Ak-yerr/MPPT-Solar-Charge-Controller-Project/Photos-&-Videos/Proto_1_Test_Circuit.jpg

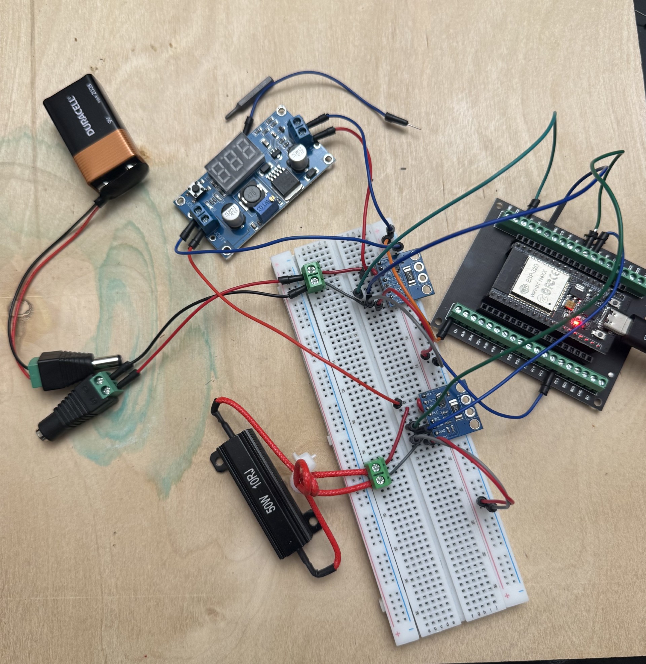
Photos-&-Videos/Proto_1_Test_Circuit.jpg
