Ak-yerr/MPPT-Solar-Charge-Controller-Project/Photos-&-Videos/async_buck_build.jpg

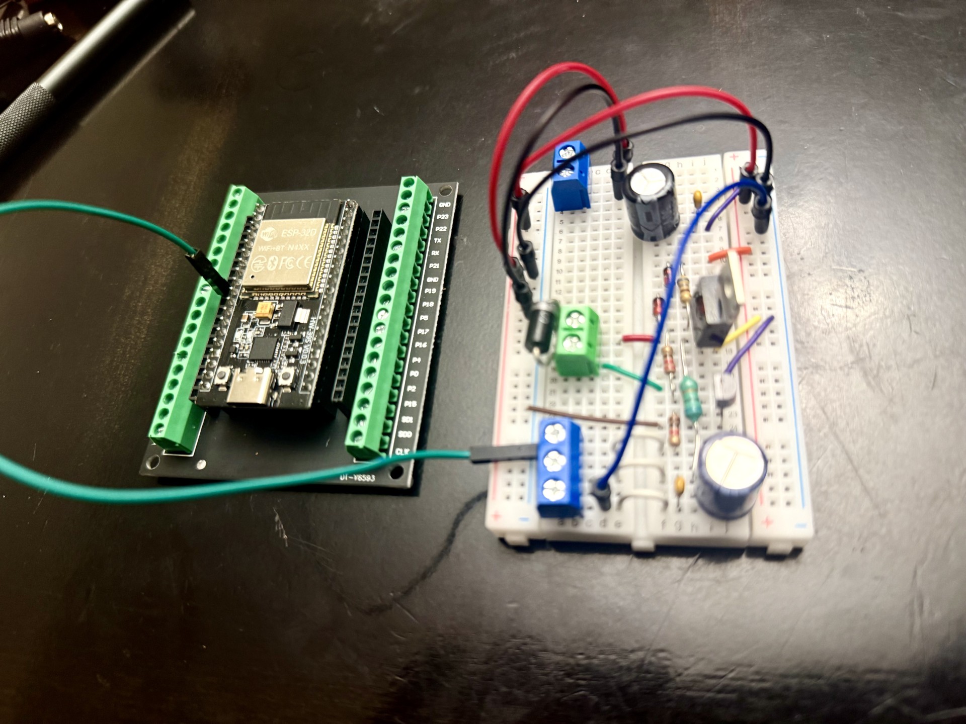
Photos-&-Videos/async_buck_build.jpg
