Ak-yerr/MPPT-Solar-Charge-Controller-Project/Custom-DC-DC-Converter/async_buck_design_math.pdf

## Asynchronous Buck — MPPT Power Stage

Design Calculations

## Givens

Vin = 18 V | Voc = 22 V | Vout = 12 V | Iout = 1.5 A
L = 560 µH | Cin = 220 µF Cout = 1000 µF | ESR = 0.1 Ω
Rds(on) = 0.117 Ω | Qg = 70 nC | VF = 0.55 V | DCR = 0.3 Ω
R1 = 1 kΩ | R2 = 220 Ω | R3 = 680 Ω | VZ = 10.2 V

## 1. Switching frequency

fsw =

fAP B
2

n

=

80 × 10⁶

2

13 =

80 × 10⁶

8192

= 9765.6 Hz

∆DLSB =

1
2

13 = 1.22 × 10⁻⁴ = 0.0122 % ∆VLSB = Vin ∆DLSB = 18 × 1.22 × 10⁻⁴ = 2.2 mV

## 2. Duty cycle

D

Vin − IoutRds(on) − Vout
| = (1 − D) (Vout + VF )

D =

Vout + VF Vin − IoutRds(on) + VF = | 12 + 0.55 18 − (1.5)(0.117) + 0.55 =
| 12.55
| 18.374 = 0.683

Dideal =

Vout

Vin

=

12
18

= 0.667 ton =

D

fsw

= 69.9 µs T =

1

fsw

= 102.4 µs

## 3. Inductor current

∆IL =

Vout(1 − D)

Lfsw

=

12(0.317)
(560 × 10⁻⁶)(9765.6) =

3.804
5.4688

= 0.696 A

Ipk = Iout +

∆IL
2

= 1.5 + 0.348 = 1.85 A Imin = 1.5 − 0.348 = 1.15 A

IL(rms) =

r
I

2
out +

∆I

2
L
12

=

r
2.25 +

0.4844
12

=

√
2.2904 = 1.513 A

Iout(crit) =

∆IL
2

= 0.348 A Rload(crit) =

Vout

Iout(crit)

=

12
0.348

= 34.5 Ω Rload =

12
1.5

= 8 Ω < 34.5 Ω

## 4. Capacitors

∆VC =

∆IL

8fswCout

=

0.696
8(9765.6)(10⁻³)

= 8.9 mV ∆VESR = ∆IL · ESR = 0.696(0.1) = 69.6 mV

∆Vout = ∆VC + ∆VESR = 78.5 mVpp

ICin(rms) = Ioutp
D(1 − D) = 1.5

p
(0.683)(0.317) = 1.5

√
0.2165 = 0.698 A

∆Vin =

IoutD(1 − D)

Cinfsw

=

1.5(0.2165)
(220 × 10⁻⁶)(9765.6) =

0.3248
2.1484

= 0.151 V

## 5. Gate drive

VZ = 2 × VZ(1N4733A) = 2(5.1) = 10.2 V < 20 V =

VGS(max)
| VGS(unclamped) = −Voc = −22 V

IR3 =

VZ
R3

=

10.2
680

= 15.0 mA IR2 =

Vin − VZ − Vce(sat)
R2

=

18 − 10.2 − 0.2
220

= 34.5 mA

IZ = IR2 − IR3 = 34.5 − 15.0 = 19.5 mA PZ = VZIZ = 10.2(19.5 × 10⁻³ ) = 0.199W < 2W

PR2 =

(Vin − VZ − Vce)

2

R2

D =

7.6

2

220

(0.683) = 0.179W PR3 =

V

2
Z
R3

D =

10.2

2

680

(0.683) = 0.105W

IB =

VGP IO − VBE
R1

=

3.3 − 0.7
1000

= 2.6 mA βreq =

IR2
IB

=

34.5
2.6

= 13.3 ≪ hF E = 250

ton =

Qg
IZ

=

70 × 10⁻⁹
19.5 × 10⁻³

= 3.6 µs tof f =

Qg

IR3

=

70 × 10⁻⁹
15.0 × 10⁻³

= 4.7 µs

ton + tof f
T

=

8.3
102.4

= 8.1 % (Qg = 180 nC : ton = 9.2 µs, tof f = 12.0 µs, 20.7 %)

## 6. Losses

Psw =

1
2

VinIout(ton + tof f )fsw =

1/2(18)(1.5)(8.3 × 10⁻⁶
)(9765.6) = 1.09W

Pcond = I

2

outRds(on)D = (1.5)²
(0.117)(0.683) = 0.180W PD = VF Iout(1−D) = 0.55(1.5)(0.317) = 0.261W

PL = I

2

L(rms)DCR = (1.513)²

(0.3) = 0.687W Pdrive = VinIR2D = 18(34.5×10⁻³ )(0.683) = 0.424W

Psh = 2I

2

outRsh = 2(1.5)²
(0.02) = 0.090W
Term | W
| Psw | 1.09
Pcond | 0.18
| PD | 0.26
| PL | 0.69
Pdrive | 0.42
| Psh | 0.09
Ploss | 2.73
Pout = VoutIout = 18W | η =
| | Pout
| | Pout + Ploss

=

| | | 18
| | | 20.73

= 86.8 %

Qg = 180 nC : | Psw = 2.73W, | Ploss = 4.37W, | η =

18
22.37

= 80.5 %

## 7. INA226

Imax =

Vsh(F S)

Rsh

=

81.92 × 10⁻³

0.1

= 0.819 A < 1.5 A 81.92 × 10⁻³

0.02

= 4.10 A > 1.5 A

Current LSB = Imax,exp
2

15 =

1.5
32768

= 45.8 µA → 50 µA

CAL = | 0.00512
Current LSB · Rsh

=

0.00512
(50 × 10⁻⁶)(0.02) =

0.00512
10⁻⁶

= 5120

Power LSB = 25 · Current LSB = 1.25 mW | Vbus(LSB) = 1.25 mV, | Vbus(F S) = 40.96 V > Voc

## 8. Control loop

fc =

1
2π

√
LCout

=

1
2π

p
(560 × 10⁻⁶)(10⁻³)
| =
| 1
2π(7.483 × 10⁻⁴)
| | = 212.7 Hz

fsw
fc

=

9765.6
212.7

= 45.9 τ =

1
2πfc
= 0.75 ms | 5τ = 3.7 ms ≪ tP &O = 100 ms
∆Dstep = 15 · ∆DLSB = 1.83 × 10⁻³ | ∆Vstep = Vin∆Dstep = 33 mV

Iinrush = Cout

dV
dt = 10⁻³
12
0.2
= 60 mA ≪ Iout

DPWM = 1 − D (inverting stage) D ∈ [0, 1] (no bootstrap constraint)

## 9. Thermal

PQ1 = Psw + Pcond = 1.09 + 0.18 = 1.27W

∆TJA = PQ1RθJA = 1.27(62) = 79 ◦C ∆TJA(hs) = 1.27(20) = 25 ◦C

∆TD = PDRθJA = 0.261(30) = 7.8

◦C ∆TL = PLRθ = 0.687(30) = 21 ◦C
