Ak-yerr/MPPT-Solar-Charge-Controller-Project/Design/MPPT_Proto_1_Planning.pdf

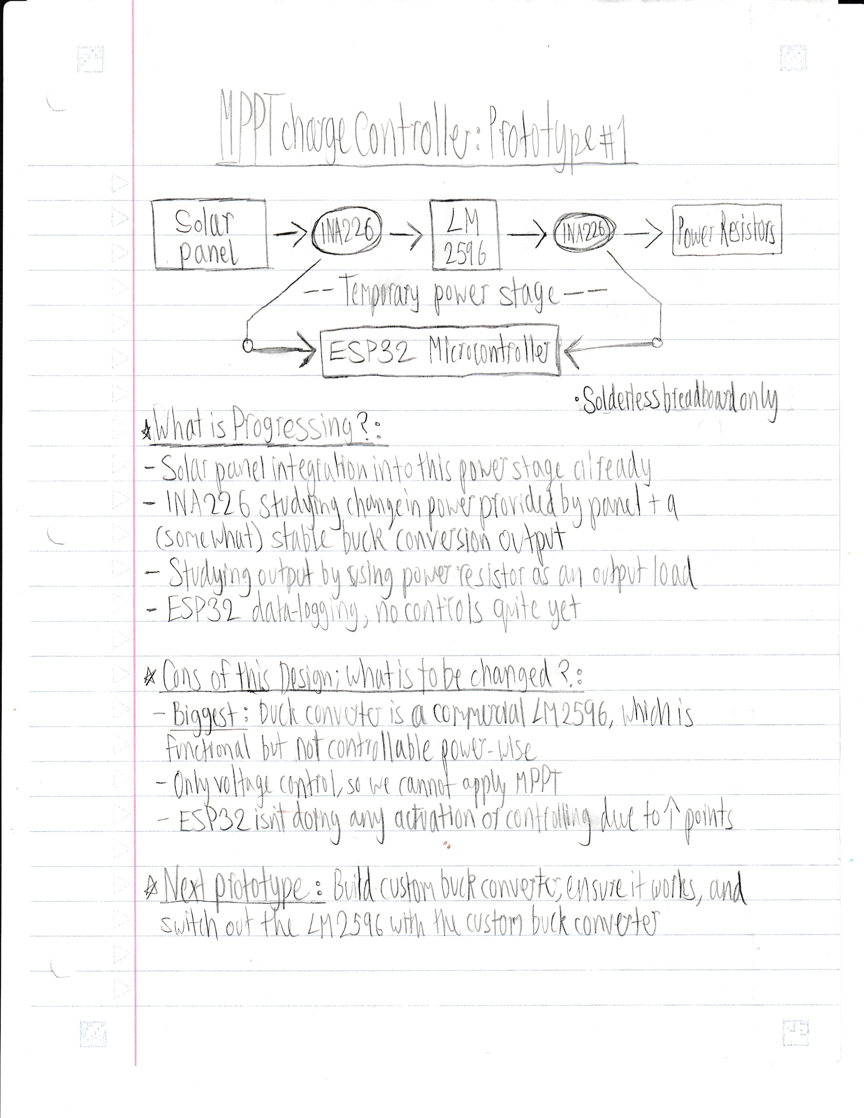
[picture p4: page 1]
