Ak-yerr/MPPT-Solar-Charge-Controller-Project/Custom-DC-DC-Converter/async_buck_schematic.png

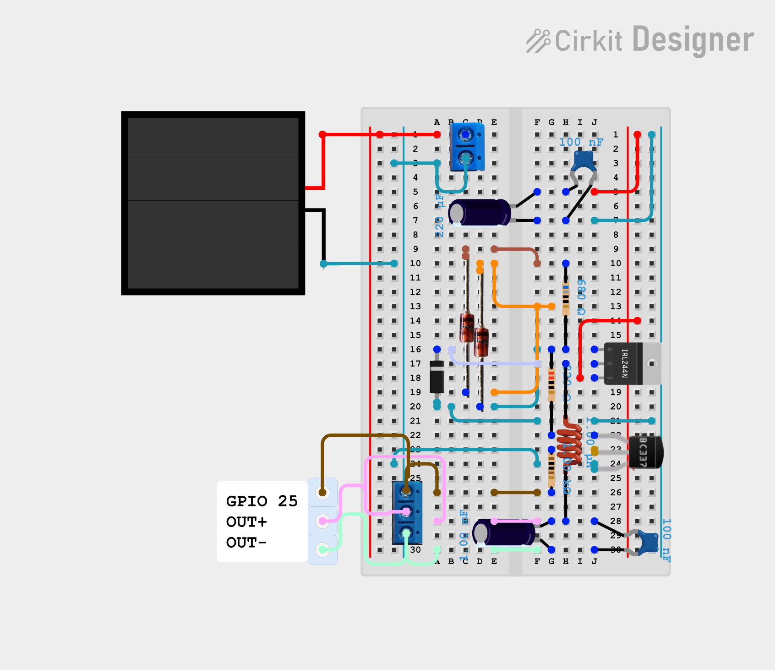
Custom-DC-DC-Converter/async_buck_schematic.png
