Ak-yerr/MPPT-Solar-Charge-Controller-Project/Custom-DC-DC-Converter/Buck-Converter-Circuit.webp

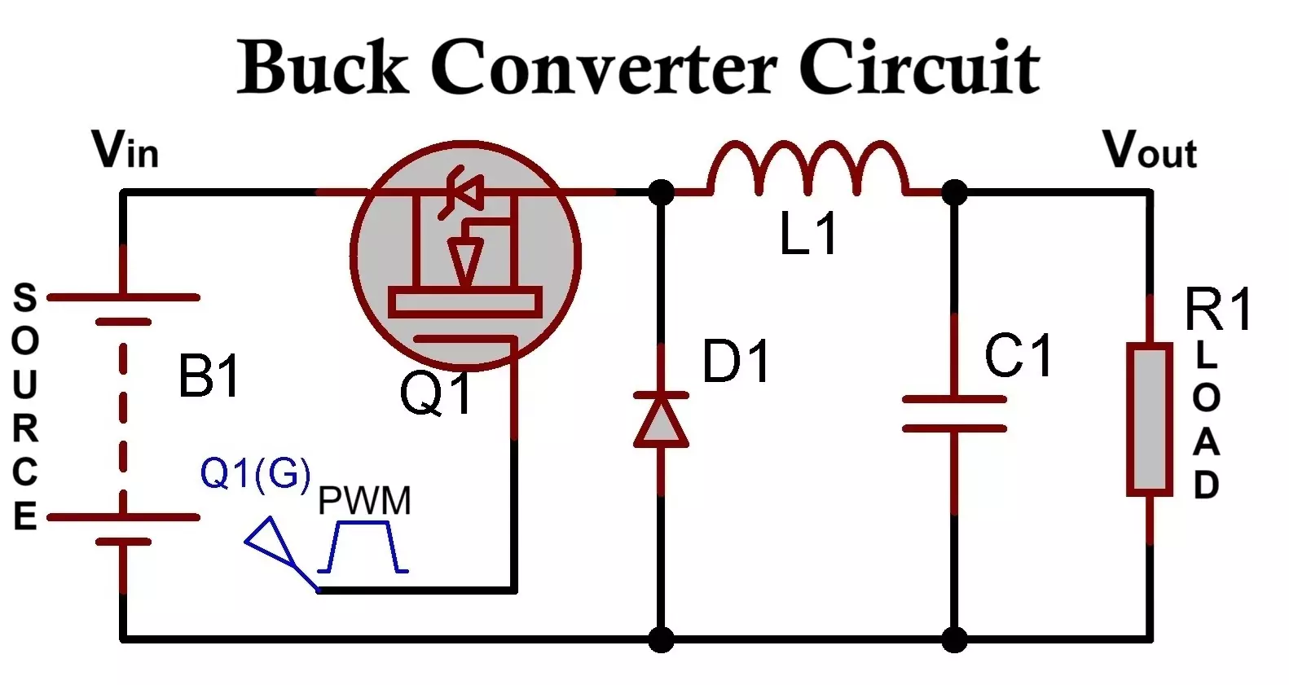
Custom-DC-DC-Converter/Buck-Converter-Circuit.webp
