Ak-yerr/MPPT-Solar-Charge-Controller-Project/Design/MPPT_Proto_1_Schematic.png

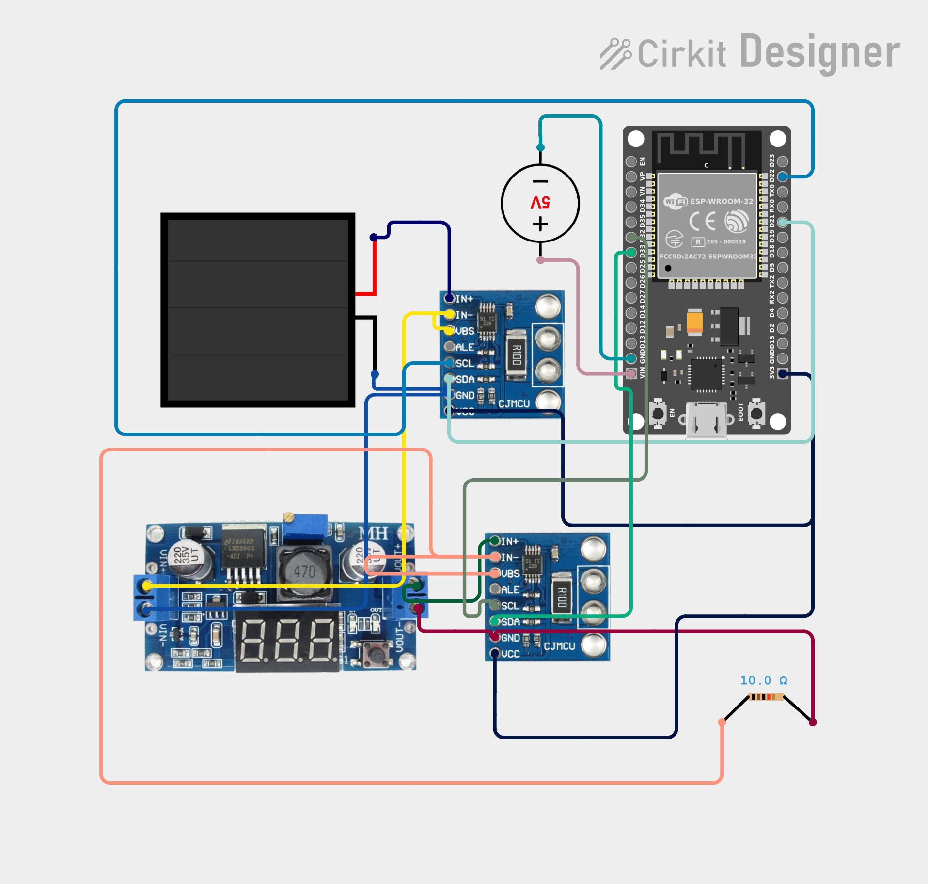
Design/MPPT_Proto_1_Schematic.png
