Ak-yerr/MPPT-Solar-Charge-Controller-Project/Design/MPPT_Proto_2_schematic.png

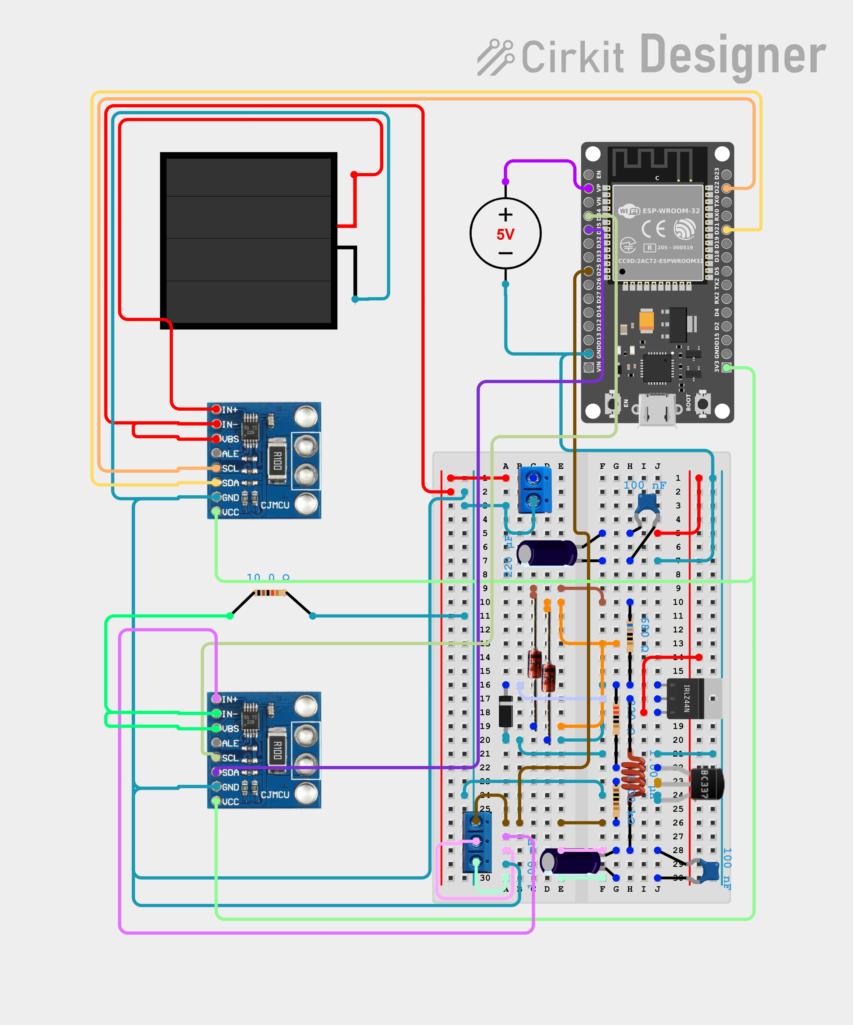
Design/MPPT_Proto_2_schematic.png
