Ak-yerr/MPPT-Solar-Charge-Controller-Project/Photos-&-Videos/async_buck_circuit.jpg

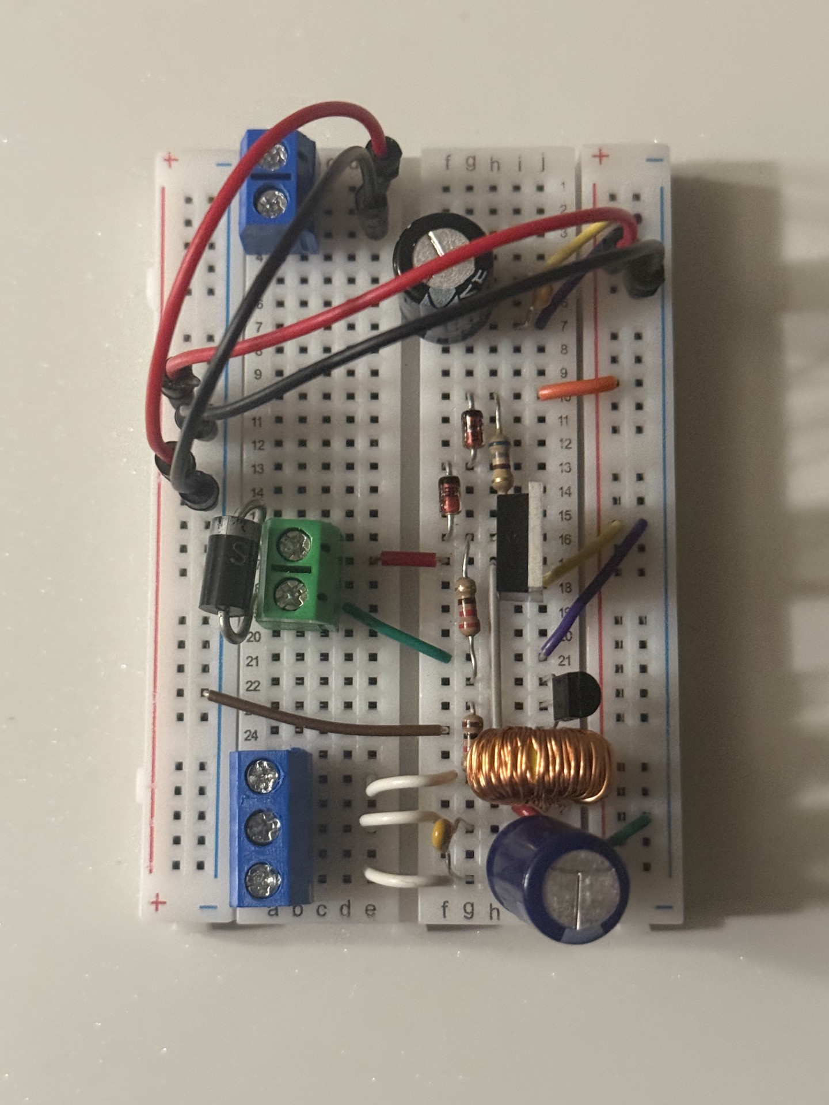
Photos-&-Videos/async_buck_circuit.jpg
