Ak-yerr/MPPT-Solar-Charge-Controller-Project/Photos-&-Videos/async_buck_iso.jpg

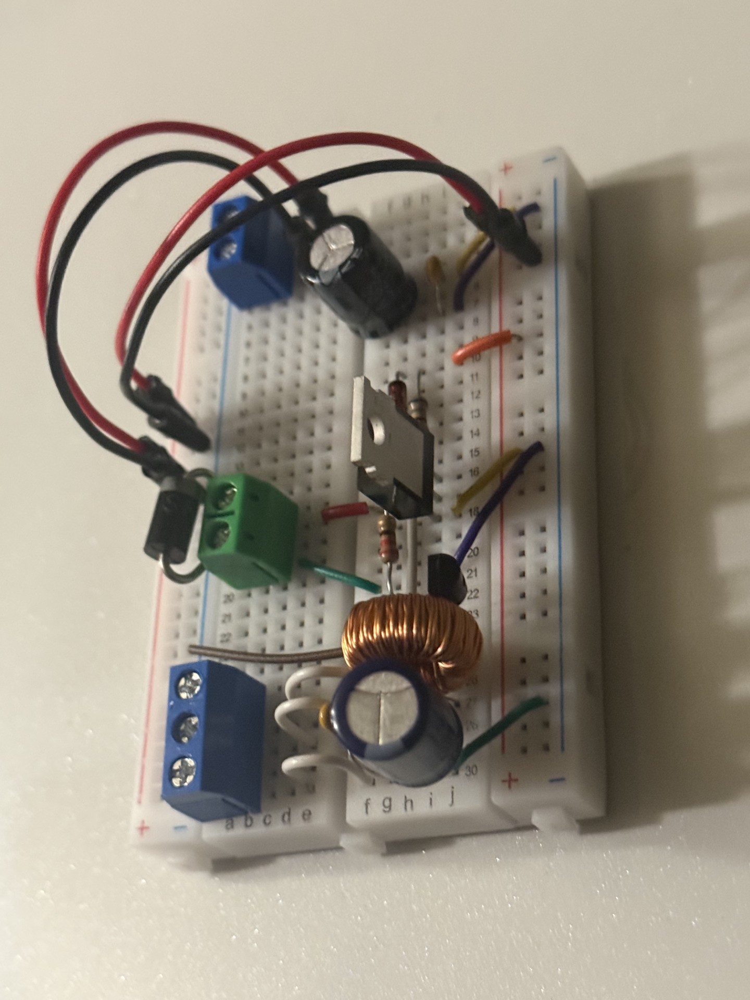
Photos-&-Videos/async_buck_iso.jpg
