Ak-yerr/MPPT-Solar-Charge-Controller-Project/Photos-&-Videos/MPPT_Proto_A_Circuit.jpg

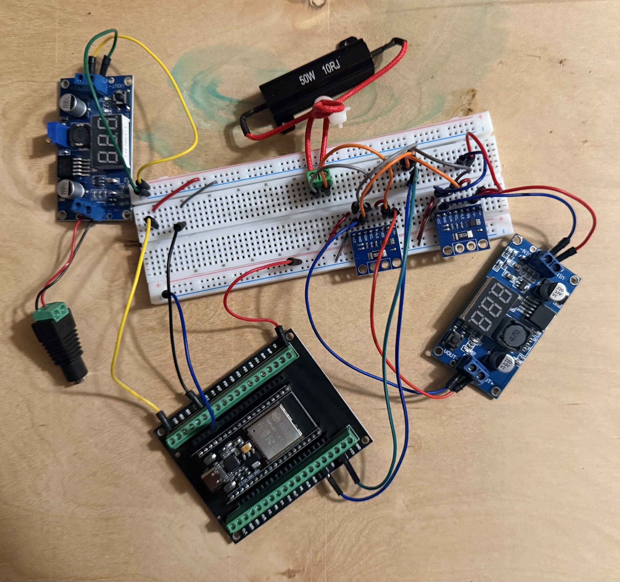
Photos-&-Videos/MPPT_Proto_A_Circuit.jpg
