Ak-yerr/MPPT-Solar-Charge-Controller-Project/Photos-&-Videos/MPPT_Solar_Charge_Controller_Circuit.jpg

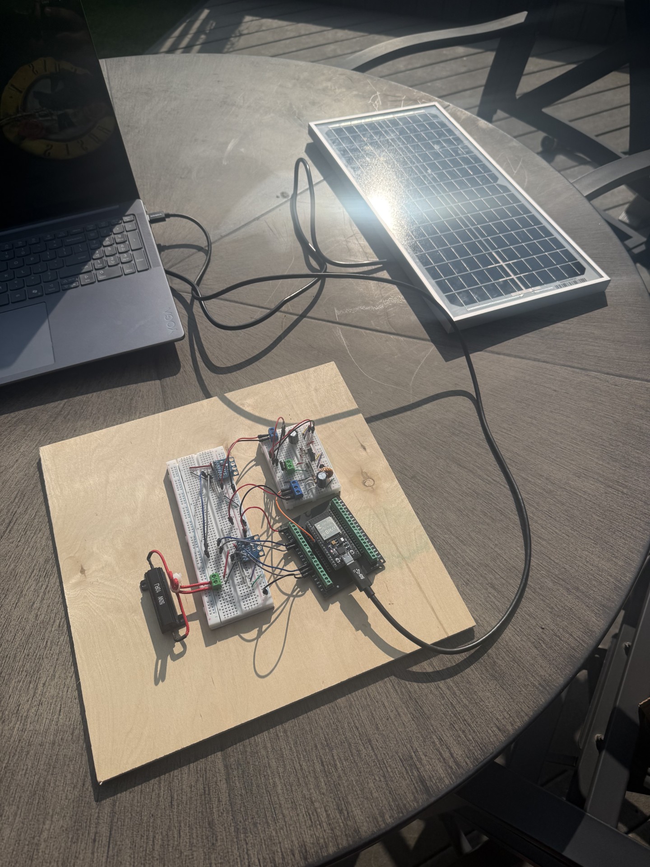
Photos-&-Videos/MPPT_Solar_Charge_Controller_Circuit.jpg
