Ak-yerr/MPPT-Solar-Charge-Controller-Project/Photos-&-Videos/MPPT_Proto_2_3_setup.jpeg

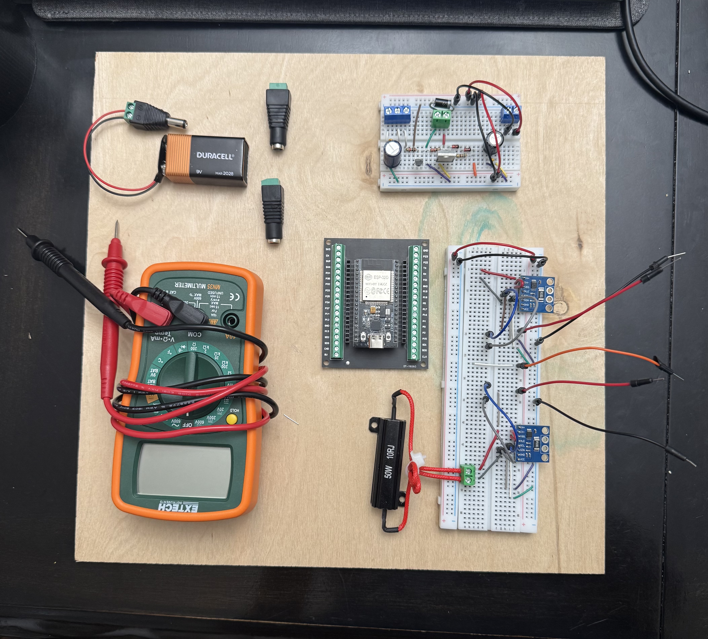
Photos-&-Videos/MPPT_Proto_2_3_setup.jpeg
