Ak-yerr/MPPT-Solar-Charge-Controller-Project/Testing/Project_ MPPT Solar Charge Controller - Testing - Summary.pdf

## Testing summary — all figures are live readings

Metric | A — Direct | B — LM2596 | C — MPPT
Mean power harvested, Pin (W) | 0.228299279 | 0.58215554 | 4.509211096
Mean power delivered, Pout (W) | 0.228299279 | 0.269130536 | 3.307055439
Peak power delivered (W) | 0.37107 | 0.43743 | 4.54579
Minimum power delivered (W) | 0.01064 | 0.01255 | 0.7038
Mean panel voltage, Vin (V) | 0.701659653 | 1.789210633 | 18.08391406
Mean panel current, Iin (A) | 0.284502263 | 0.284502021 | 0.262436226
Mean load voltage, Vout (V) | 0.701659653 | 0.721812237 | 2.641373947
Mean load current, Iout (A) | 0.284502263 | 0.32602174 | 1.193032586
Mean converter efficiency | 1 | 0.4623 | 0.8734
Energy delivered over 300 s (J) | 68.4897837 | 80.7391609 | 992.1166316
Delivered power vs Circuit A | 1 | 2.549966618 | 19.75131553
Sample count | 30000 | 30000 | 30000
