Ak-yerr/MPPT-Solar-Charge-Controller-Project/Photos-&-Videos/INA226_test_circuit.jpeg

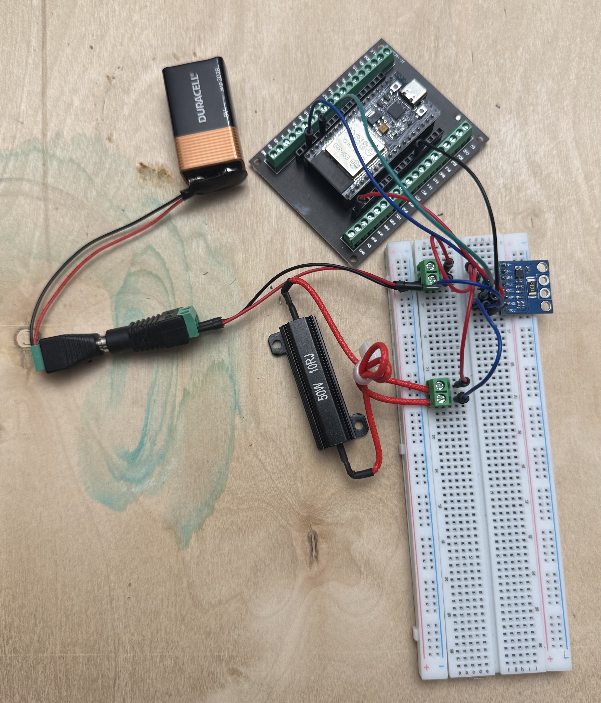
Photos-&-Videos/INA226_test_circuit.jpeg
