Ak-yerr/MPPT-Solar-Charge-Controller-Project/Photos-&-Videos/MPPT_Testing_environment.jpg

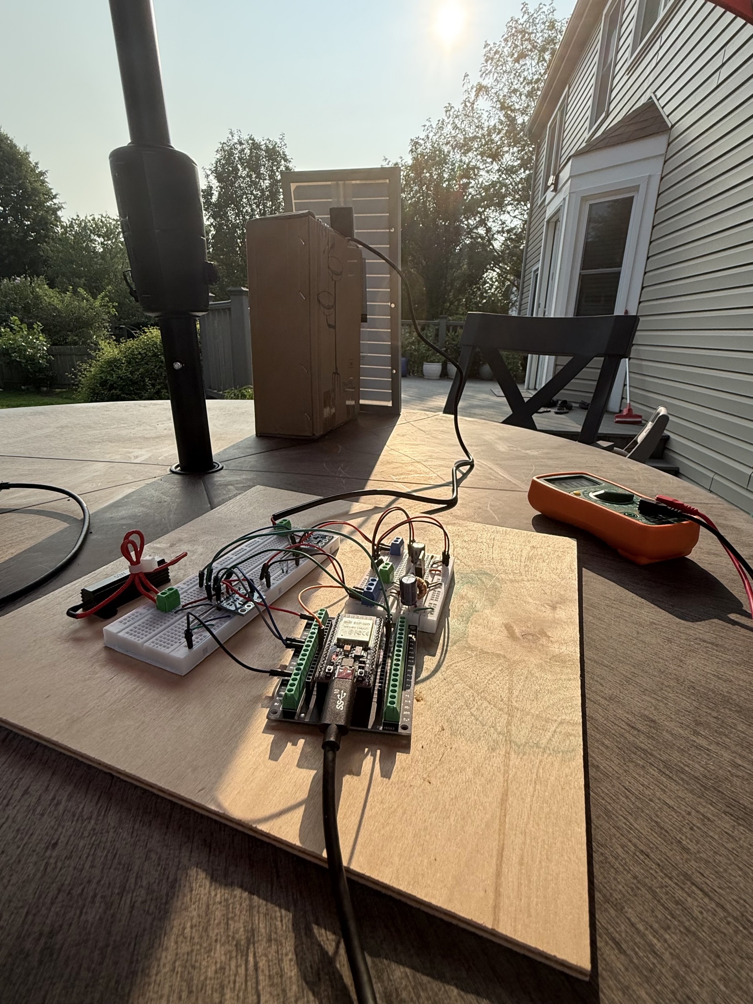
Photos-&-Videos/MPPT_Testing_environment.jpg
