Ak-yerr/MPPT-Solar-Charge-Controller-Project/Testing/MPPT_highlight_data.png

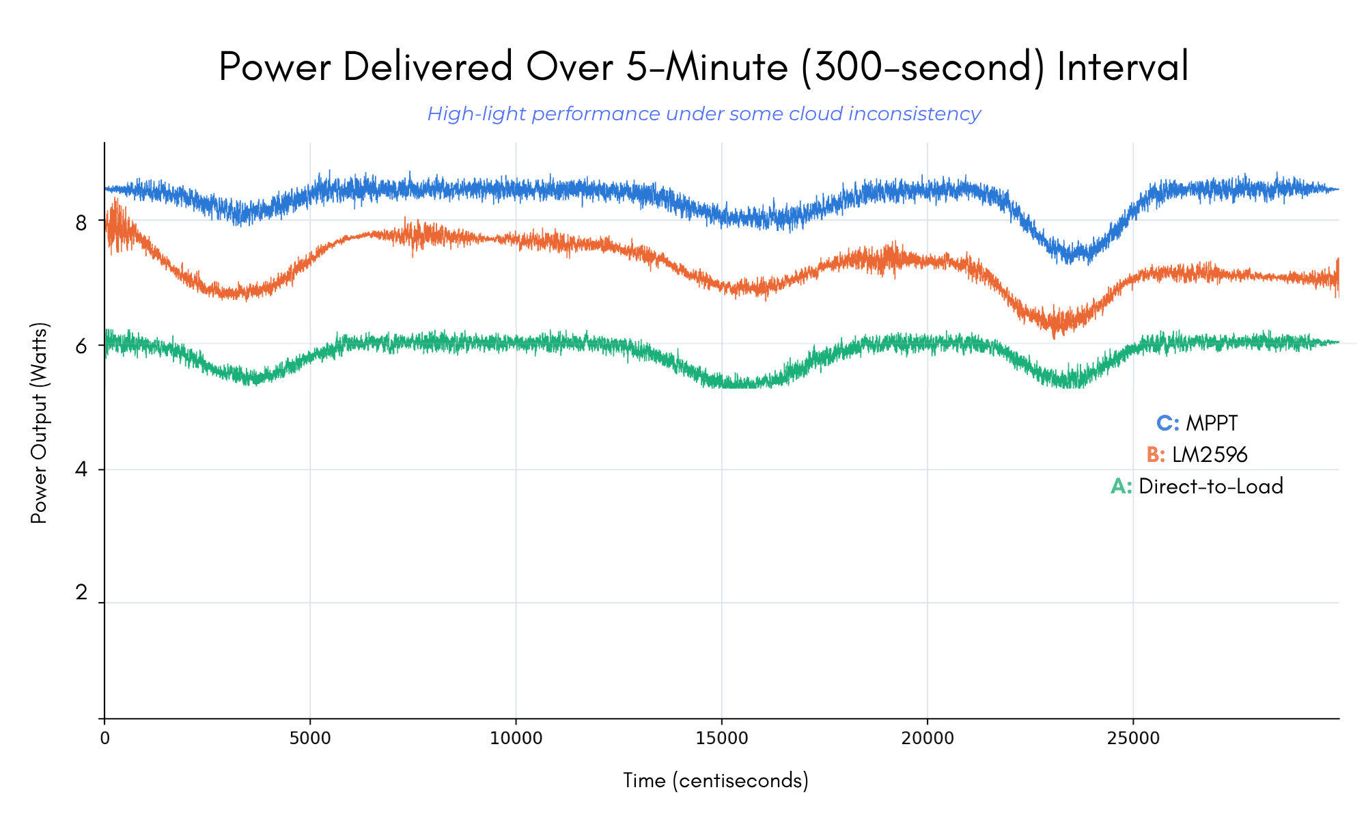
Testing/MPPT_highlight_data.png
