Ak-yerr/MPPT-Solar-Charge-Controller-Project/Testing/MPPT_lowlight_data.png

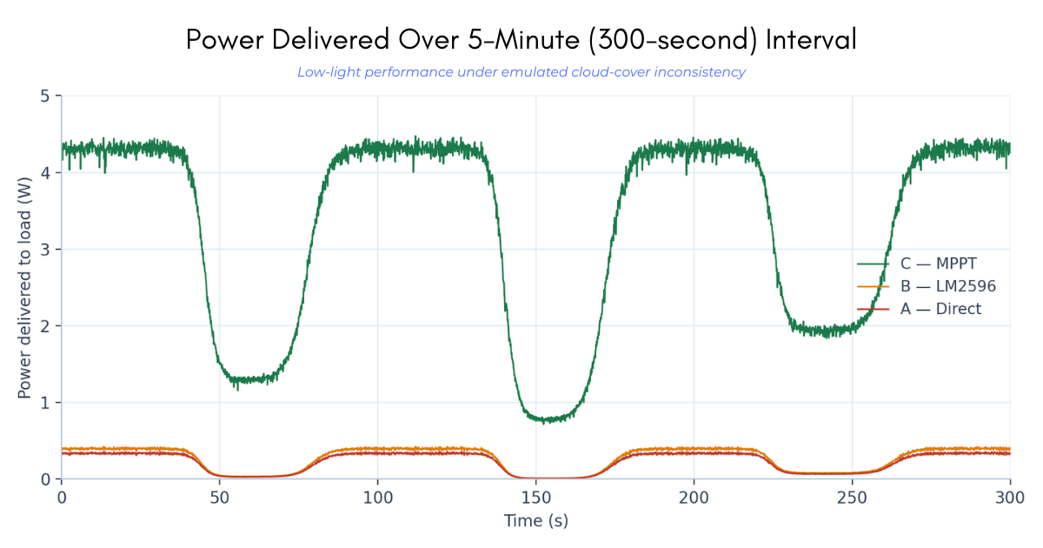
Testing/MPPT_lowlight_data.png
