Ak-yerr/MPPT-Solar-Charge-Controller-Project/Testing/sim3_tracker_response.png

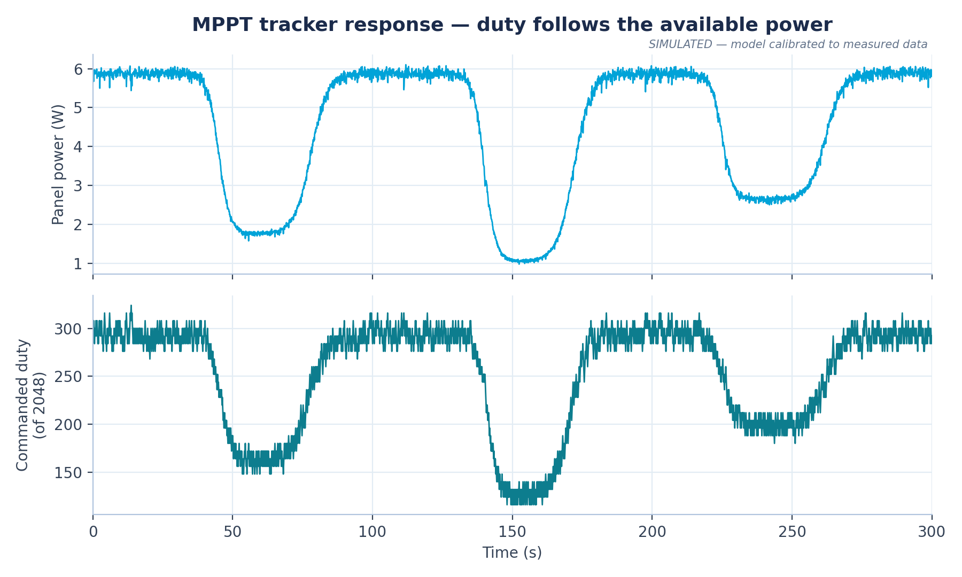
Testing/sim3_tracker_response.png
