Ak-yerr/MPPT-Solar-Charge-Controller-Project/(commit log)

2026-08-01 Add Schematic for Prototype A
2026-08-02 Create Custom Buck
2026-08-04 Added Extracted Circuit for Prototype A pretesting
2026-08-04 Add Corrected Schematic for Stage 1
2026-08-05 Added I2C test
2026-08-05 Added INA226 test circuit
2026-08-05 Added 9V test data
2026-08-05 Added Proto 1 Circuit (without panel)
2026-08-07 Added buck stuff
2026-08-07 Added buck photo
2026-08-07 Added buck schem
2026-08-08 Added buck schematic (updated)
